jahrWork/AtenTTo_platform/README.md

# AtenTTo-platform

A hardware and software platform to monitor and to control hydraulic and thermal systems in buildings

It comprises: 
  1) AtentTTo core:  a PCB with a microcontroller  SAM 32 bits ARM (arduino due compatible).
  2) AtenTTo multipurpose: a PCB with sensors  and actuators in which AtenTTo core is plugged in. 
  3) Free embedded software to control and upload monitoring data to some specific server.
